mickdermack/bbcar_stw_adc/README.md

# bbcar_stw_adc

ESP32 and STM32 board for steering wheel mounted operation on a Bobby Car by mickdermack and fanosta.
