mickdermack/bbcar_stw_adc/hardware/README.md

# Prerequisites

Add the following footprint library under the name "otter": https://github.com/Jan--Henrik/KiCAD-libs
