mickdermack/bbcar_stw_adc/hardware/bbcar_stw_adc/bbcar_stw_adc.kicad_pcb

## KiCad design hardware/bbcar_stw_adc/bbcar_stw_adc.kicad_pcb (2021-04-11)

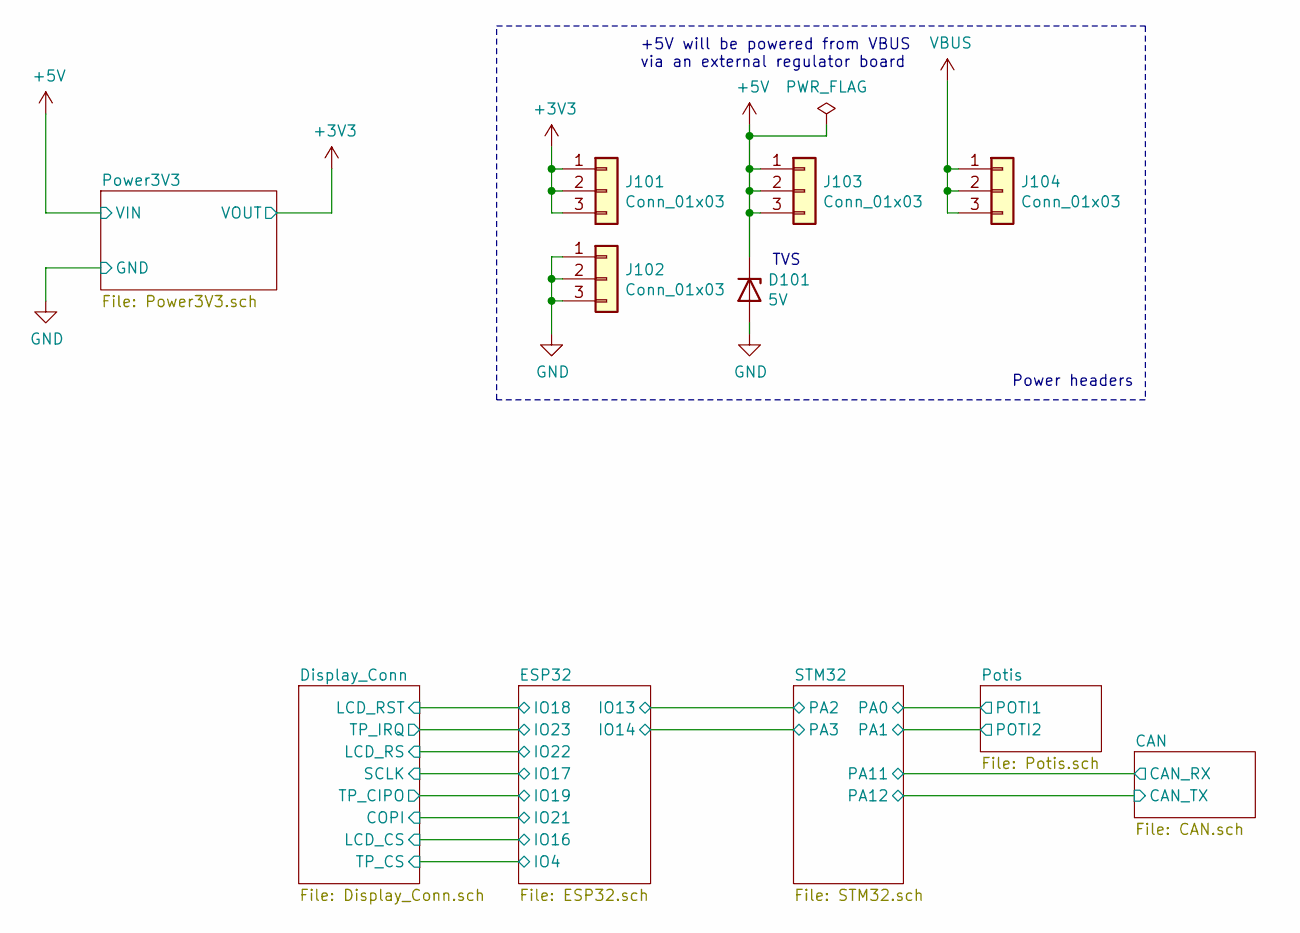
[picture p1: schematic bbcar_stw_adc.sch]

Parts:
D101: 5V; D_SOD-128; Mouser Nr 771-PTVS5V0P1UP115
J101, J102, J103, J104: Conn_01x03; PinHeader_1x03_P2.54mm_Vertical

Connections:
+3V3: J101.1, J101.2, J101.3; also elsewhere on the board
+5V: D101.1 (K), J103.1, J103.2, J103.3; also elsewhere on the board
GND: D101.2 (A), J102.1, J102.2, J102.3; also elsewhere on the board
VBUS: J104.1, J104.2, J104.3; also elsewhere on the board

Notes on the sheet:
Power headers
+5V will be powered from VBUS via an external regulator board
TVS

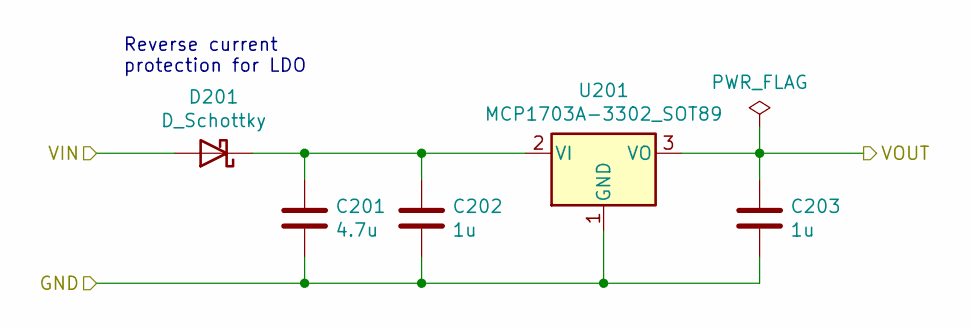
[picture p2: schematic Power3V3.sch]

Parts:
C201: 4.7u; C_0805_2012Metric; Mouser Nr 963-EMF212AB7475KGHT
C202, C203: 1u; C_0805_2012Metric; Mouser Nr 963-UMF212B7105KGHT
D201: D_Schottky; D_SOD-123W; Mouser Nr 771-PMEG3010ER115
U201: MCP1703A-3302_SOT89; SOT-89-3; Mouser Nr 579-MCP1703AT3302EMB

Connections:
+3V3: C203.1, U201.3 (VO); also elsewhere on the board
+5V: D201.2 (A); also elsewhere on the board
GND: C201.2, C202.2, C203.2, U201.1 (GND); also elsewhere on the board
unnamed: C201.1, C202.1, D201.1 (K), U201.2 (VI)

Notes on the sheet:
Reverse current protection for LDO

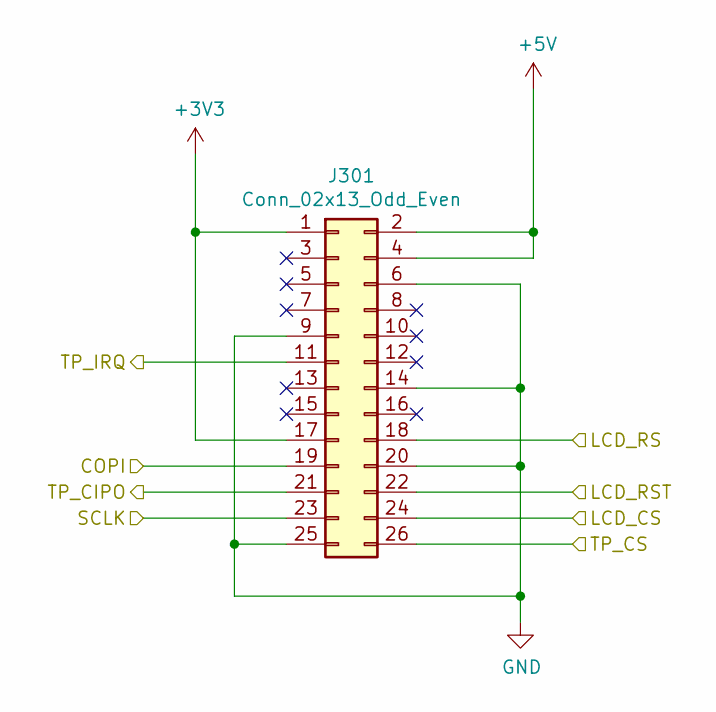
[picture p3: schematic Display_Conn.sch]

Parts:
J301: Conn_02x13_Odd_Even; PinHeader_2x13_P2.54mm_Vertical

Connections:
+3V3: J301.1, J301.17; also elsewhere on the board
+5V: J301.2, J301.4; also elsewhere on the board
/Display_Conn/COPI: J301.19; also elsewhere on the board
/ESP32/IO4: J301.26; also elsewhere on the board
/ESP32/IO16: J301.24; also elsewhere on the board
/ESP32/IO17: J301.23; also elsewhere on the board
/ESP32/IO18: J301.22; also elsewhere on the board
/ESP32/IO19: J301.21; also elsewhere on the board
/ESP32/IO22: J301.18; also elsewhere on the board
/ESP32/IO23: J301.11; also elsewhere on the board
GND: J301.6, J301.9, J301.14, J301.20, J301.25; also elsewhere on the board

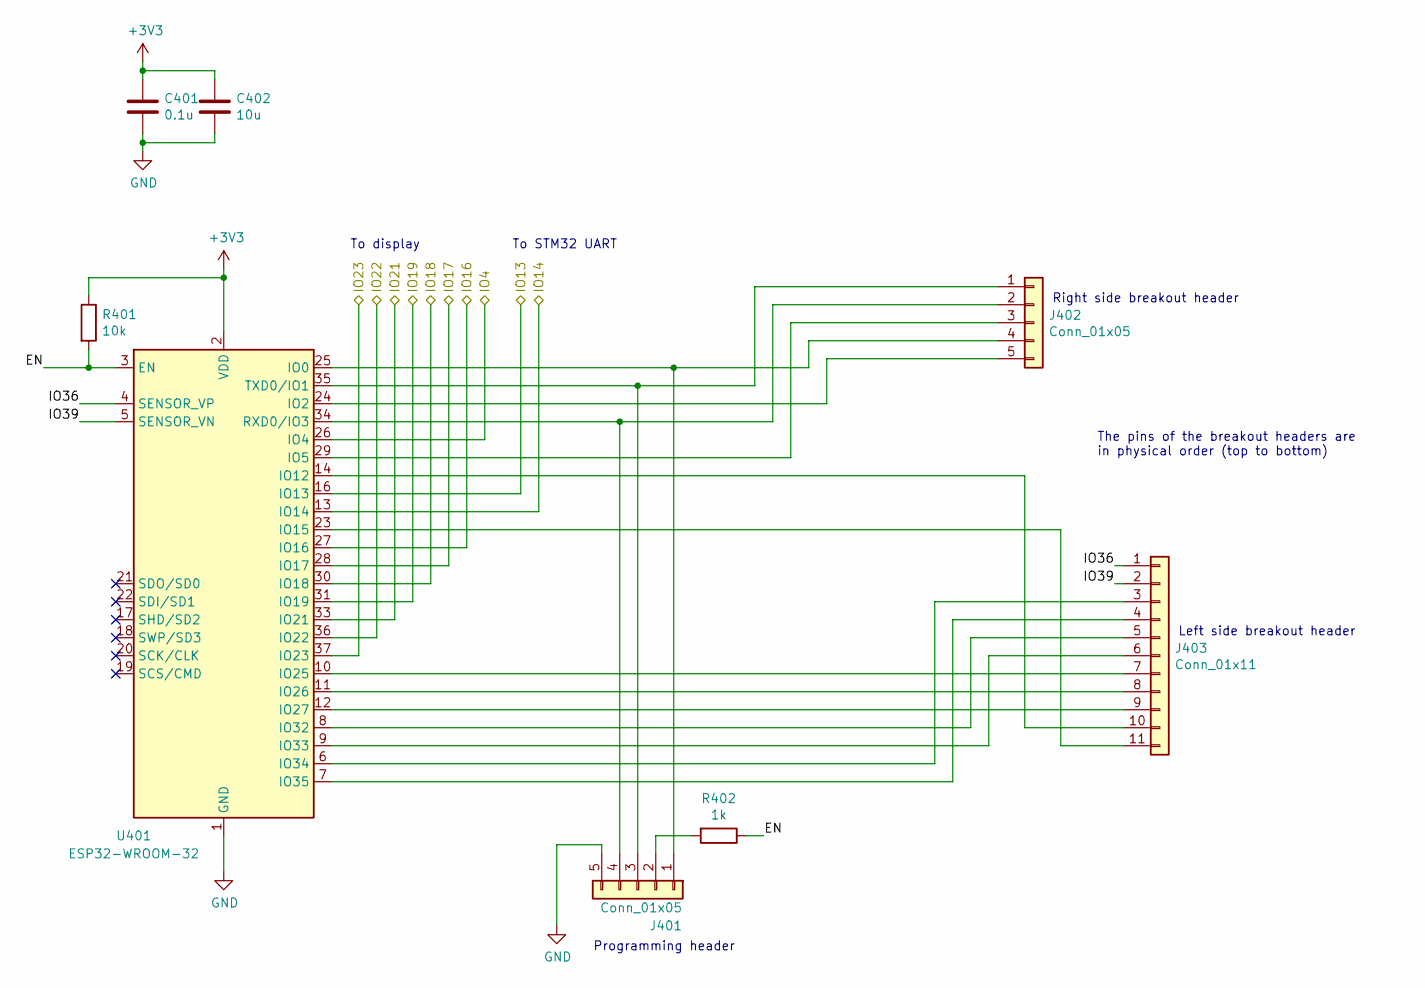
[picture p4: schematic ESP32.sch]

Parts:
C401: 0.1u; C_0603_1608Metric; Mouser Nr 963-HMK107B7104KAHT
C402: 10u; C_0603_1608Metric; Mouser Nr 963-LMK107BBJ106MAHT
J401, J402: Conn_01x05; PinHeader_1x05_P2.54mm_Vertical
J403: Conn_01x11; PinHeader_1x11_P2.54mm_Vertical
R401: 10k; R_0603_1608Metric; Mouser Nr 667-ERJ-3GEYJ103V
R402: 1k; R_0603_1608Metric; Mouser Nr 667-ERJ-3GEYJ102V
U401: ESP32-WROOM-32

Connections:
+3V3: C401.1, C402.1, R401.1, U401.2 (VDD); also elsewhere on the board
/Display_Conn/COPI: U401.33 (IO21); also elsewhere on the board
/ESP32/EN: R401.2, R402.1, U401.3 (EN)
/ESP32/IO4: U401.26 (IO4); also elsewhere on the board
/ESP32/IO13: U401.16 (IO13); also elsewhere on the board
/ESP32/IO14: U401.13 (IO14); also elsewhere on the board
/ESP32/IO16: U401.27 (IO16); also elsewhere on the board
/ESP32/IO17: U401.28 (IO17); also elsewhere on the board
/ESP32/IO18: U401.30 (IO18); also elsewhere on the board
/ESP32/IO19: U401.31 (IO19); also elsewhere on the board
/ESP32/IO22: U401.36 (IO22); also elsewhere on the board
/ESP32/IO23: U401.37 (IO23); also elsewhere on the board
/ESP32/IO36: J403.1, U401.4 (SENSOR_VP)
/ESP32/IO39: J403.2, U401.5 (SENSOR_VN)
GND: C401.2, C402.2, J401.5, U401.1 (GND), U401.15 (GND), U401.38 (GND), U401.39 (GND); also elsewhere on the board
unnamed: J401.1, J402.4, U401.25 (IO0)
unnamed: J401.2, R402.2
unnamed: J401.3, J402.1, U401.35 (TXD0/IO1)
unnamed: J401.4, J402.2, U401.34 (RXD0/IO3)
unnamed: J402.3, U401.29 (IO5)
unnamed: J402.5, U401.24 (IO2)
unnamed: J403.3, U401.6 (IO34)
unnamed: J403.4, U401.7 (IO35)
unnamed: J403.5, U401.8 (IO32)
unnamed: J403.6, U401.9 (IO33)
unnamed: J403.7, U401.10 (IO25)
unnamed: J403.8, U401.11 (IO26)
unnamed: J403.9, U401.12 (IO27)
unnamed: J403.10, U401.14 (IO12)
unnamed: J403.11, U401.23 (IO15)

Notes on the sheet:
Right side breakout header
To display
Programming header
To STM32 UART
The pins of the breakout headers are in physical order (top to bottom)
Left side breakout header

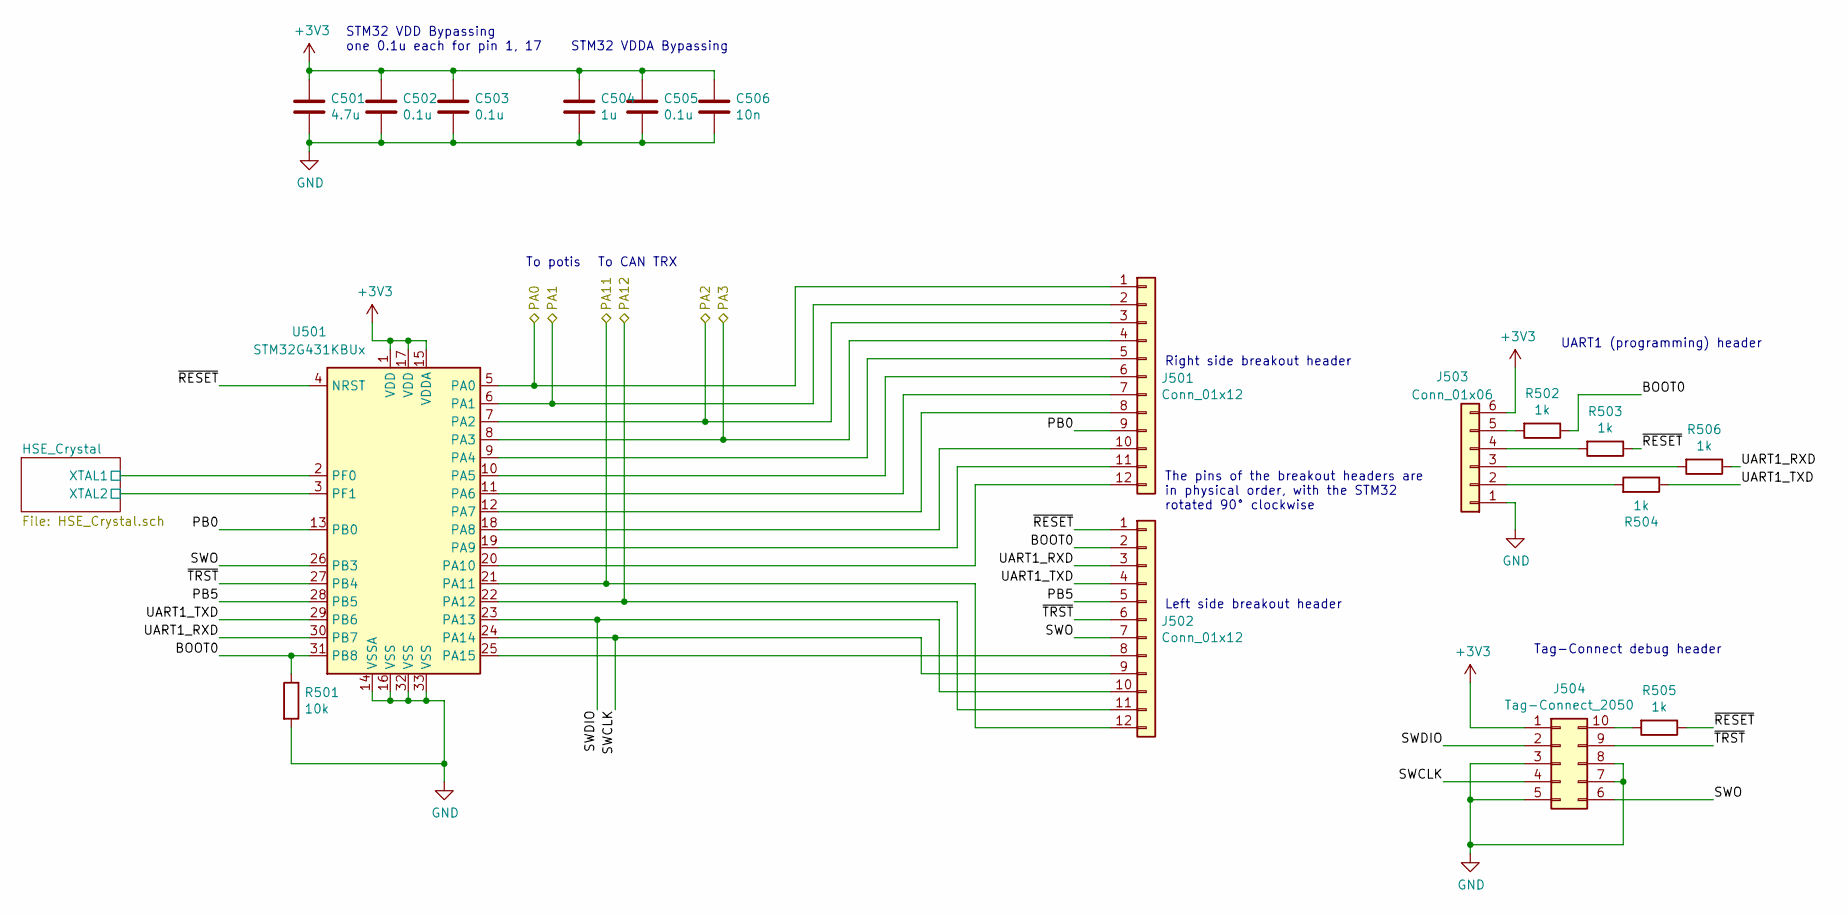
[picture p5: schematic STM32.sch]

Parts:
C501: 4.7u; C_0805_2012Metric; Mouser Nr 963-EMF212AB7475KGHT
C502, C503, C505: 0.1u; C_0603_1608Metric; Mouser Nr 963-HMK107B7104KAHT
C504: 1u; C_0805_2012Metric; Mouser Nr 963-UMF212B7105KGHT
C506: 10n; C_0603_1608Metric; Mouser Nr 963-UMK107B7103KAHT
J501, J502: Conn_01x12; PinHeader_1x12_P2.54mm_Vertical
J503: Conn_01x06; PinHeader_1x06_P2.54mm_Vertical
J504: Tag-Connect_2050; Tag-Connect_TC2050-IDC-NL_2x05_P1.27mm_Vertical
R501: 10k; R_0603_1608Metric; Mouser Nr 667-ERJ-3GEYJ103V
R502, R503, R504, R505, R506: 1k; R_0603_1608Metric; Mouser Nr 667-ERJ-3GEYJ102V
U501: STM32G431KBUx; QFN-32-1EP_5x5mm_P0.5mm_EP3.45x3.45mm; Mouser Nr 511-STM32G431KBU6

Connections:
+3V3: C501.1, C502.1, C503.1, C504.1, C505.1, C506.1, J503.6, J504.1, U501.1 (VDD), U501.15 (VDDA), U501.17 (VDD); also elsewhere on the board
/CAN/CAN_RX: J502.12, U501.21 (PA11); also elsewhere on the board
/CAN/CAN_TX: J502.11, U501.22 (PA12); also elsewhere on the board
/ESP32/IO13: J501.3, U501.7 (PA2); also elsewhere on the board
/ESP32/IO14: J501.4, U501.8 (PA3); also elsewhere on the board
/STM32/BOOT0: J502.2, R501.1, R502.1, U501.31 (PB8)
/STM32/HSE_Crystal/XTAL1: U501.2 (PF0); also elsewhere on the board
/STM32/HSE_Crystal/XTAL2: U501.3 (PF1); also elsewhere on the board
/STM32/PA0: J501.1, U501.5 (PA0); also elsewhere on the board
/STM32/PA1: J501.2, U501.6 (PA1); also elsewhere on the board
/STM32/PB0: J501.9, U501.13 (PB0)
/STM32/PB5: J502.5, U501.28 (PB5)
/STM32/SWCLK: J502.9, J504.4, U501.24 (PA14)
/STM32/SWDIO: J502.10, J504.2, U501.23 (PA13)
/STM32/SWO: J502.7, J504.6, U501.26 (PB3)
/STM32/UART1_RXD: J502.3, R506.1, U501.30 (PB7)
/STM32/UART1_TXD: J502.4, R504.1, U501.29 (PB6)
/STM32/~RESET: J502.1, R503.1, R505.1, U501.4 (NRST)
/STM32/~TRST: J502.6, J504.9, U501.27 (PB4)
GND: C501.2, C502.2, C503.2, C504.2, C505.2, C506.2, J503.1, J504.3, J504.5, J504.7, J504.8, R501.2, U501.14 (VSSA), U501.16 (VSS), U501.32 (VSS), U501.33 (VSS); also elsewhere on the board
unnamed: J501.5, U501.9 (PA4)
unnamed: J501.6, U501.10 (PA5)
unnamed: J501.7, U501.11 (PA6)
unnamed: J501.8, U501.12 (PA7)
unnamed: J501.10, U501.18 (PA8)
unnamed: J501.11, U501.19 (PA9)
unnamed: J501.12, U501.20 (PA10)
unnamed: J502.8, U501.25 (PA15)
unnamed: J503.2, R504.2
unnamed: J503.3, R506.2
unnamed: J503.4, R503.2
unnamed: J503.5, R502.2
unnamed: J504.10, R505.2

Notes on the sheet:
Tag-Connect debug header
UART1 (programming) header
To potis
STM32 VDD Bypassing one 0.1u each for pin 1, 17
STM32 VDDA Bypassing
To CAN TRX
Right side breakout header
Left side breakout header
The pins of the breakout headers are in physical order, with the STM32 rotated 90° clockwise

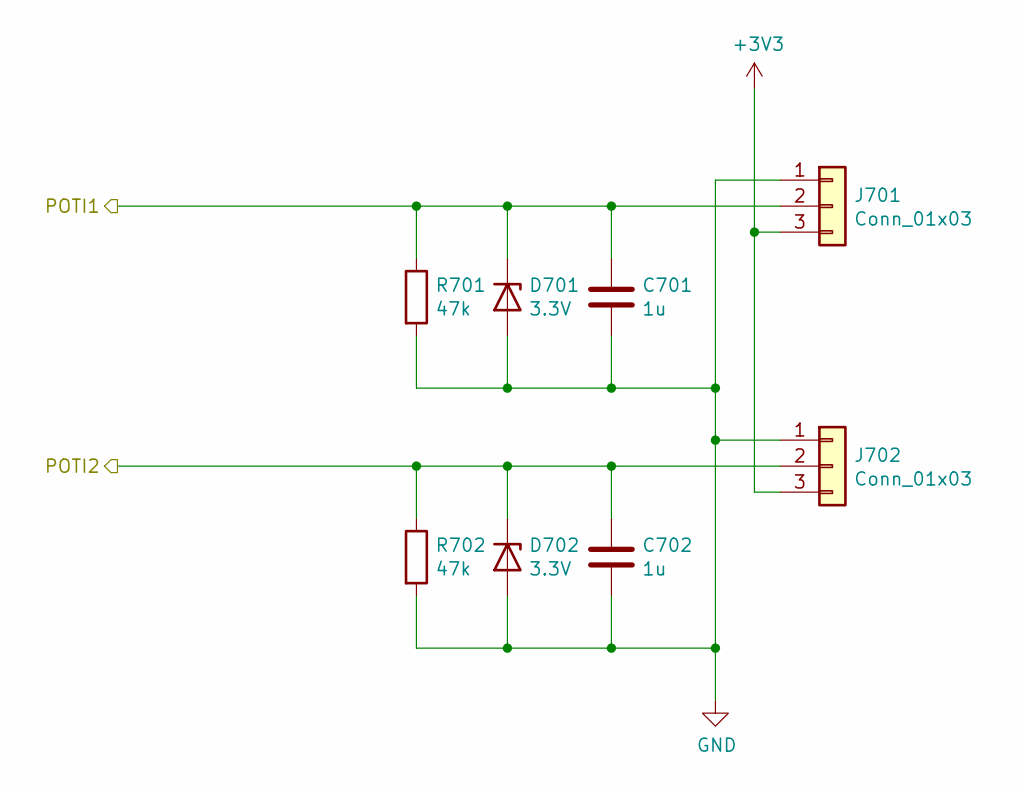
[picture p6: schematic Potis.sch]

Parts:
C701, C702: 1u; C_0805_2012Metric; Mouser Nr 963-UMF212B7105KGHT
D701, D702: 3.3V; D_0603_1608Metric; Mouser Nr 771-PESD3V3Y1BSFYL
J701, J702: Conn_01x03; PinHeader_1x03_P2.54mm_Vertical
R701, R702: 47k; R_0603_1608Metric; Mouser Nr 667-ERJ-3EKF4702V

Connections:
+3V3: J701.3, J702.3; also elsewhere on the board
/STM32/PA0: C701.1, D701.1 (K), J701.2, R701.1; also elsewhere on the board
/STM32/PA1: C702.1, D702.1 (K), J702.2, R702.1; also elsewhere on the board
GND: C701.2, C702.2, D701.2 (A), D702.2 (A), J701.1, J702.1, R701.2, R702.2; also elsewhere on the board

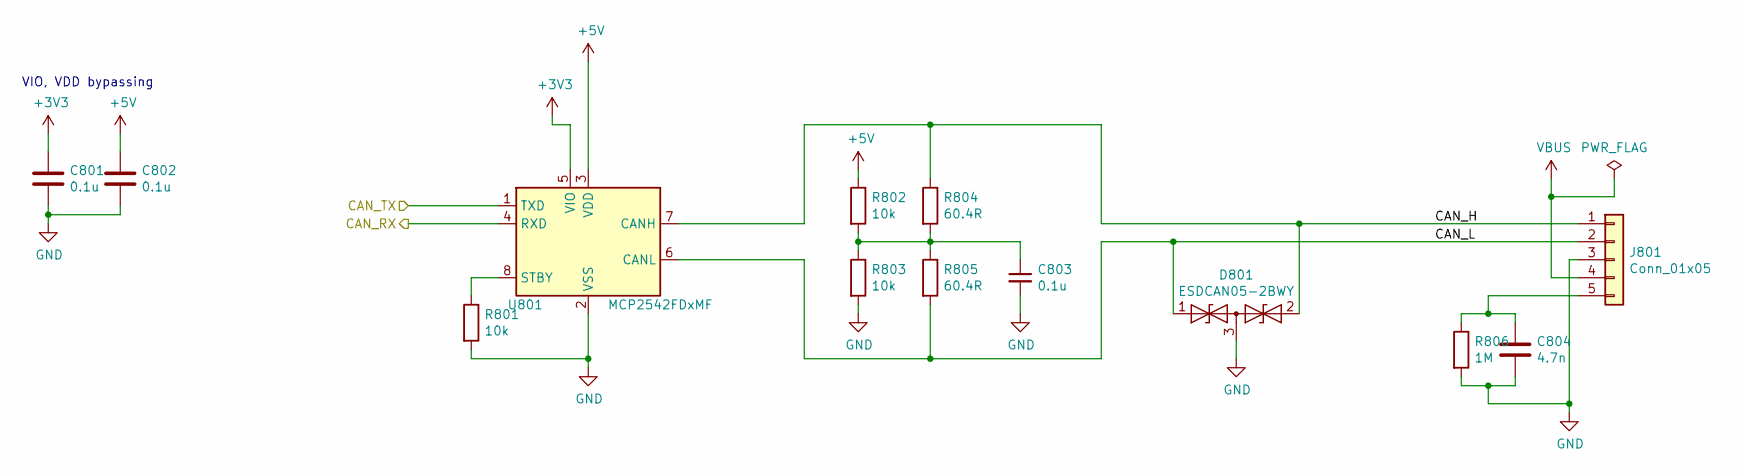
[picture p7: schematic CAN.sch]

Parts:
C801, C802, C803: 0.1u; C_0603_1608Metric; Mouser Nr 963-HMK107B7104KAHT
C804: 4.7n; C_0805_2012Metric; Mouser Nr 963-QMK212B7472KGHT
D801: ESDCAN05-2BWY; SOT-323_SC-70; Mouser Nr 511-ESDCAN05-2BWY
J801: Conn_01x05; PinHeader_1x05_P2.54mm_Vertical
R801, R802, R803: 10k; R_0603_1608Metric; Mouser Nr 667-ERJ-3GEYJ103V
R804, R805: 60.4R; R_0603_1608Metric; Mouser Nr 603-RC0603FR-0760R4L
R806: 1M; R_0603_1608Metric; Mouser Nr 667-ERJ-PA3J105V
U801: MCP2542FDxMF; DFN-8-1EP_3x3mm_P0.65mm_EP1.55x2.4mm; Mouser Nr 579-MCP2542FD-E/MF

Connections:
+3V3: C801.1, U801.5 (VIO); also elsewhere on the board
+5V: C802.1, R802.1, U801.3 (VDD); also elsewhere on the board
/CAN/CAN_H: D801.2 (A2), J801.1, R804.1, U801.7 (CANH)
/CAN/CAN_L: D801.1 (A1), J801.2, R805.2, U801.6 (CANL)
/CAN/CAN_RX: U801.4 (RXD); also elsewhere on the board
/CAN/CAN_TX: U801.1 (TXD); also elsewhere on the board
GND: C801.2, C802.2, C803.2, C804.2, D801.3 (common), J801.3, R801.2, R803.2, R806.2, U801.2 (VSS), U801.9 (VSS); also elsewhere on the board
unnamed: C803.1, R802.2, R803.1, R804.2, R805.1
unnamed: C804.1, J801.5, R806.1
unnamed: R801.1, U801.8 (STBY)
VBUS: J801.4; also elsewhere on the board

Notes on the sheet:
VIO, VDD bypassing

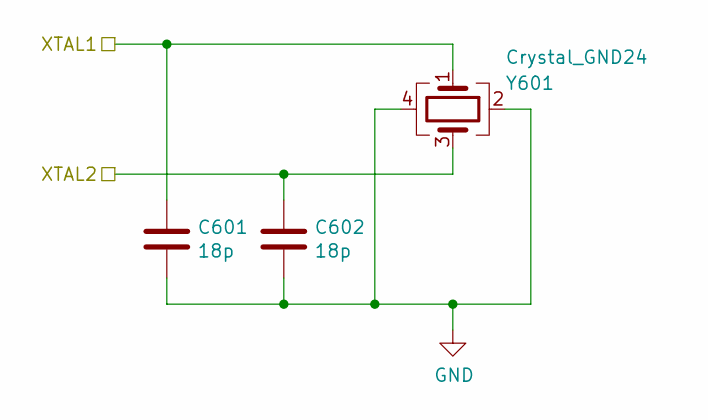
[picture p8: schematic HSE_Crystal.sch]

Parts:
C601, C602: 18p; C_0603_1608Metric; Mouser Nr 80-C0603C180J5GAUTO
Y601: Crystal_GND24; Crystal_SMD_Abracon_ABMM2-4Pin_6.0x3.6mm; Mouser Nr 815-ABMM2-8-E2T

Connections:
/STM32/HSE_Crystal/XTAL1: C601.1, Y601.1; also elsewhere on the board
/STM32/HSE_Crystal/XTAL2: C602.1, Y601.3; also elsewhere on the board
GND: C601.2, C602.2, Y601.2, Y601.4; also elsewhere on the board

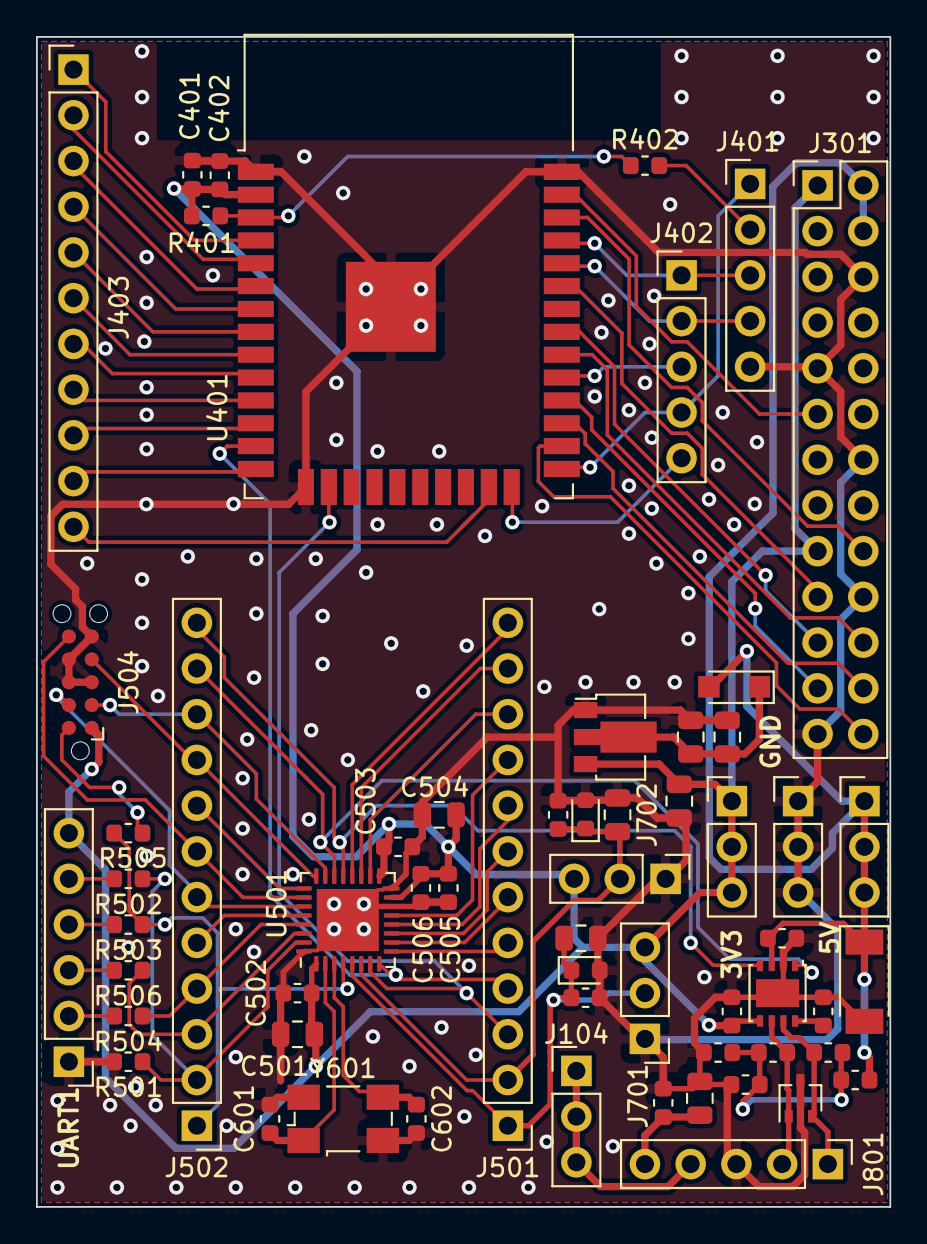
[picture p9: board bbcar_stw_adc.kicad_pcb from above]

Board: 2 copper layers, 47.4 x 65.0 mm, 60 parts (0 on the bottom side), 67 nets.
