mickdermack/bbcar_stw_adc/software/Src/main.cpp

/**
  ******************************************************************************
  * @file           : main.c
  * @brief          : Main program body
  ******************************************************************************
  * @attention
  *
  * <h2><center>&copy; Copyright (c) 2020 STMicroelectronics.
  * All rights reserved.</center></h2>
  *
  * This software component is licensed by ST under BSD 3-Clause license,
  * the "License"; You may not use this file except in compliance with the
  * License. You may obtain a copy of the License at:
  *                        opensource.org/licenses/BSD-3-Clause
  *
  ******************************************************************************
  */

#include <vector>
#include <algorithm>

#include "main.h"

#include "can.h"
#include "can_feedc0de.h"
#include "serial_esp.h"
#include "serial_feedc0de.h"
#include "protocol.h"
#include "cruise_controller.h"
#include "debouncer.h"
#include "config.h"

// PA4 as cruise control button
#define GPIO_CRUISE_CONTROL GPIOA
#define GPIO_PIN_CRUISE_CONTROL GPIO_PIN_4

ADC_HandleTypeDef hadc1;
ADC_HandleTypeDef hadc2;


UART_HandleTypeDef huart1;

void SystemClock_Config(void);
static void MX_GPIO_Init(void);
static void MX_ADC12_Init(void);
static void MX_USART1_UART_Init(void);
static void MX_DMA_Init(void);

CANFeedc0de<Command, Feedback> can_instances[NUM_BOARDS_MAX] = {
  {
    CAN_ID_COMMAND_STW_TO_BOARD(0),
    CAN_ID_COMMAND_BOARD_TO_STW(0),
    CAN_ID_FEEDBACK_STW_TO_BOARD(0),
    CAN_ID_FEEDBACK_BOARD_TO_STW(0)
  },
  {
    CAN_ID_COMMAND_STW_TO_BOARD(1),
    CAN_ID_COMMAND_BOARD_TO_STW(1),
    CAN_ID_FEEDBACK_STW_TO_BOARD(1),
    CAN_ID_FEEDBACK_BOARD_TO_STW(1)
  },
  {
    CAN_ID_COMMAND_STW_TO_BOARD(2),
    CAN_ID_COMMAND_BOARD_TO_STW(2),
    CAN_ID_FEEDBACK_STW_TO_BOARD(2),
    CAN_ID_FEEDBACK_BOARD_TO_STW(2)
  }
};

SerialFeedc0de serial_feedc0de;

static Feedback feedback;
static Command command;

Debouncer cc_button_debouncer(50 / MAIN_LOOP_DELAY_MS);
CruiseController cruise_controller;
static bool controlling_cruise = false;
Debouncer cc_disengage(500 / MAIN_LOOP_DELAY_MS);
Debouncer cc_buzzer(1000 / MAIN_LOOP_DELAY_MS);

static void check_cruise_control(int16_t current_pwm)
{
  bool cc_button_state = !HAL_GPIO_ReadPin(GPIO_CRUISE_CONTROL, GPIO_PIN_CRUISE_CONTROL);
  if (cc_button_debouncer.update(cc_button_state))
  {
    if (!controlling_cruise)
    {
      controlling_cruise = true;
      int16_t current_speed = (feedback.left.speed + feedback.right.speed) / 2;
      cruise_controller.start(current_speed, current_pwm);
    }
    else
    {
      controlling_cruise = false;
    }

    command.buzzer.freq = 4;
    cc_buzzer.update(false);
  }
}

// Assumes this is called with constant frequency
static void adc_to_motorstate(uint16_t gas, uint16_t brake, MotorState& motorState)
{
  // Clamp poti values if out of range
  gas = std::clamp(gas, (uint16_t)ADC_GAS_MIN, (uint16_t)ADC_GAS_MAX);
  brake = std::clamp(brake, (uint16_t)ADC_BRAKE_MIN, (uint16_t)ADC_BRAKE_MAX);

  motorState.iMotMax = 30;
  motorState.iDcMax = 35;
  motorState.enable = true;
  motorState.ctrlTyp = ControlType::FieldOrientedControl;
  motorState.ctrlMod = ControlMode::Voltage;
  motorState.fieldWeakMax = 10;
  motorState.nMotMax = 2000;

  int16_t gas_of_1500 = -1500 * (gas - ADC_GAS_MIN) / (ADC_GAS_MAX - ADC_GAS_MIN);
  int16_t brake_of_1500 = 1500 * (brake - ADC_BRAKE_MIN) / (ADC_BRAKE_MAX - ADC_BRAKE_MIN);
  int16_t combined = gas_of_1500 + brake_of_1500;

  int16_t current_speed = (feedback.left.speed + feedback.right.speed) / 2;

  int16_t control_input = controlling_cruise ? cruise_controller.step(current_speed) : combined;

  static float set = 0;
  static bool initialized = false;

  // TODO tau = dT / ln(1 - alpha)
  if (initialized)
  {
    set = set * ADC_SMOOTHING + control_input * (1 - ADC_SMOOTHING);
  }
  else
  {
    set = control_input;
    initialized = true;
  }
  set = std::clamp(set, -1500.f, 1500.f);

  // If cruise control button is pressed, enable cruise control
  // with set as inital value
  check_cruise_control(set);

  if (controlling_cruise)
  {
    bool control_pressed = gas_of_1500 < -100 || brake_of_1500 > 100;
    if (cc_disengage.update(control_pressed))
    {
      controlling_cruise = false;
      command.buzzer.freq = 4;
      cc_disengage.update(false);
      cc_buzzer.update(false);
    }
  }

  if (cc_buzzer.update(true))
  {
    command.buzzer.freq = 0;
  }

  motorState.pwm = set;
}

/**
  * @brief  The application entry point.
  * @retval int
  */
int main(void)
{
  /* MCU Configuration--------------------------------------------------------*/

  /* Reset of all peripherals, Initializes the Flash interface and the Systick. */
  HAL_Init();

  /* Configure the system clock */
  SystemClock_Config();

  /* Initialize all configured peripherals */
  MX_GPIO_Init();
  MX_ADC12_Init();
  MX_USART1_UART_Init();
  MX_DMA_Init();

  serial_esp_init();
  can_init();

  // FDCAN fails after cold start if we try sending frames too early
  // (5 V power supply not stable yet?)
  HAL_Delay(50);

  // Initial conversion
  if (HAL_ADC_Start(&hadc1) != HAL_OK)
  {
    Error_Handler();
  }

  // Initial conversion
  if (HAL_ADC_Start(&hadc2) != HAL_OK)
  {
    Error_Handler();
  }

  uint32_t next_update = HAL_GetTick();

  /* Infinite loop */
  while (1)
  {
    if (HAL_GetTick() >= next_update)
    {
      if (HAL_ADC_PollForConversion(&hadc1, 1) != HAL_OK)
      {
        Error_Handler();
      }

      if (HAL_ADC_PollForConversion(&hadc2, 1) != HAL_OK)
      {
        Error_Handler();
      }

      uint32_t gas = HAL_ADC_GetValue(&hadc1);
      uint32_t brake = HAL_ADC_GetValue(&hadc2);

      adc_to_motorstate(gas, brake, command.left);
      command.right = command.left;

      for (size_t i = 0; i < NUM_BOARDS_MAX; i++)
        can_instances[i].send(command);

      // Start conversion
      if (HAL_ADC_Start(&hadc1) != HAL_OK)
      {
        Error_Handler();
      }

      if (HAL_ADC_Start(&hadc2) != HAL_OK)
      {
        Error_Handler();
      }

      next_update += MAIN_LOOP_DELAY_MS;
    }

    for (size_t i = 0; i < NUM_BOARDS_MAX; i++)
    {
      can_instances[i].poll();
    }

    if (NUM_BOARDS_MAX < 1)
      Error_Handler();

    // Got new feedback?
    // TODO: Other controllers
    if (can_instances[0].get(feedback))
    {
      serial_feedc0de.send_feedback(feedback);
    }
  }
}

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
