mickdermack/bbcar_stw_adc/software/Inc/config.h

#pragma once

// measured 601
#define ADC_GAS_MIN 650
// measured 3435
#define ADC_GAS_MAX 3425

// measured 16
#define ADC_BRAKE_MIN 25
// measured 2590
#define ADC_BRAKE_MAX 2580

#define ADC_SMOOTHING .992f

#define NUM_BOARDS_MAX 3

// update interval in milliseconds
#define MAIN_LOOP_DELAY_MS 10
