mickdermack/bbcar_stw_adc/software/Inc/serial_feedc0de.h

#pragma once

#ifdef __cplusplus
#include <cstdint>
#include "protocol.h"
class SerialFeedc0de
{
public:
  void send_feedback(const Feedback& in);
  bool tx_done();
private:
  Feedback feedback;
};

#endif
